Walden21/CS362-Hovercraft/README.md

# CS362-Hovercraft
Arduino controlled Hovercrafts

[Google Drive link to documentation](https://drive.google.com/drive/folders/0B225k-tkv4ugSzdKR01GR2txQU0?usp=sharing)
