Walden21/CS362-Hovercraft/(list of files, drawings)

Other design files:
schematics/Controller.fzz
schematics/Hovercraft.fzz
schematics/LightHouseMaster.fzz
schematics/LightHouseServant.fzz
