Walden21/CS362-Hovercraft/(commit log)

2017-11-16 Add notes for acceptable alphabet, add initial schematics for controller and hovercraft
    [Controller.fzz, Hovercraft.fzz]
2017-11-16 Move controller pins from 4,5 to 10,11
    [Controller.fzz]
2017-11-20 Add basic throttle IO code
2017-11-20 Increase range of values for throttle; added servo code to hovercraft
2017-11-20 Updated schematics with analog stick and ESCs
    [Controller.fzz, Hovercraft.fzz]
2017-11-28 Add support for second servo in back for Hovercraft.ino
2017-11-29 fixed hovercraft, now hovers, and moves along the ground- slowly
    [Hovercraft.ino]
2017-11-29 Added reading in capabilities for button presses.
2017-12-01 updated all fritzing sketches. Added external parts for bluetooth modules.
    [Controller.fzz, Hovercraft.fzz, LightHouseMaster.fzz, LightHouseServant.fzz]
2017-12-06 fixed fitzing project to include ESC's
    [Hovercraft.fzz]
2017-12-07 made slight position changes to schematics
    [LightHouseMaster.fzz, LightHouseServant.fzz]
